Scott216/Leak_Detector/Eagle Files/Leak Detector Remote v3.brd

## EAGLE design Eagle Files/Leak Detector Remote v3.brd (2022-10-18)

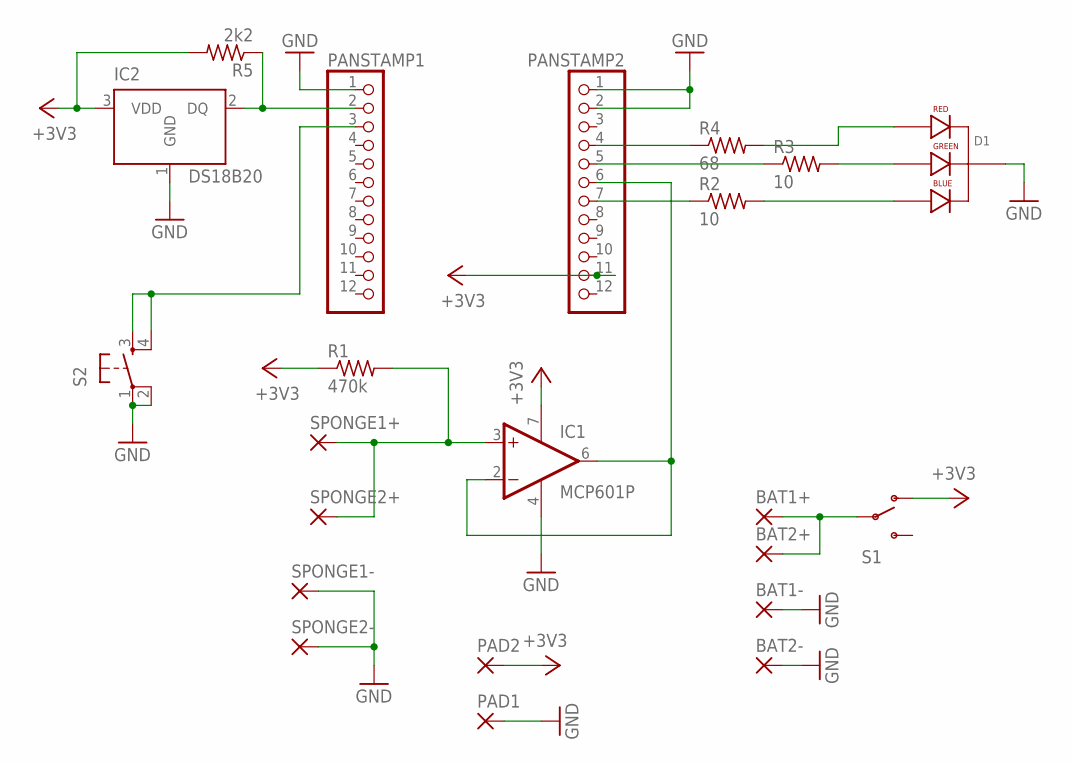
[picture p1: schematic Leak Detector Remote v3.sch]

Parts:
BAT1+, BAT1-, BAT2+, BAT2-: 3,81/1,4
D1: LED-RGB-CC-THRUCLEAR; LED-RGB-THRU
IC1: MCP601P; DIL08
IC2: DS18B20; TO-92
PAD1, PAD2: 1,6/0,9
PANSTAMP1, PANSTAMP2: PINHD-1X12; 1X12
R1: 470k; 0204/7
R2, R3: 10; 0204/7
R4: 68; 0204/7
R5: 2k2; 0204/7
S1: SWITCH-SPDTKIT; SWITCH-SPDT_KIT
S2: TAC_SWITCHPTH; TACTILE-PTH
SPONGE1+, SPONGE1-, SPONGE2+, SPONGE2-: 3,81/1,4

Connections:
+3V3: IC1.7 (V+), IC2.3 (VDD), PAD2.1, PANSTAMP2.11, R1.1, R5.2, S1.1 (O)
D3: PANSTAMP2.7, R2.1
D4: IC1.2 (-IN), IC1.6 (OUT), PANSTAMP2.6
D5: PANSTAMP2.5, R3.1
D6: PANSTAMP2.4, R4.1
D8: IC2.2 (DQ), PANSTAMP1.2, R5.1
D9: PANSTAMP1.3, S2.3, S2.4
GND: BAT1-.1, BAT2-.1, D1.2 (CATHODE), IC1.4 (V-), IC2.1 (GND), PAD1.1, PANSTAMP1.1, PANSTAMP2.1, PANSTAMP2.2, S2.1, S2.2, SPONGE1-.1, SPONGE2-.1
unnamed: IC1.3 (+IN), R1.2, SPONGE1+.1, SPONGE2+.1
unnamed: BAT1+.1, BAT2+.1, S1.2
unnamed: D1.1 (RED_CATHODE), R4.2
unnamed: D1.3 (GREEN_CATHODE), R3.2
unnamed: D1.4 (BLUE_CATHODE), R2.2

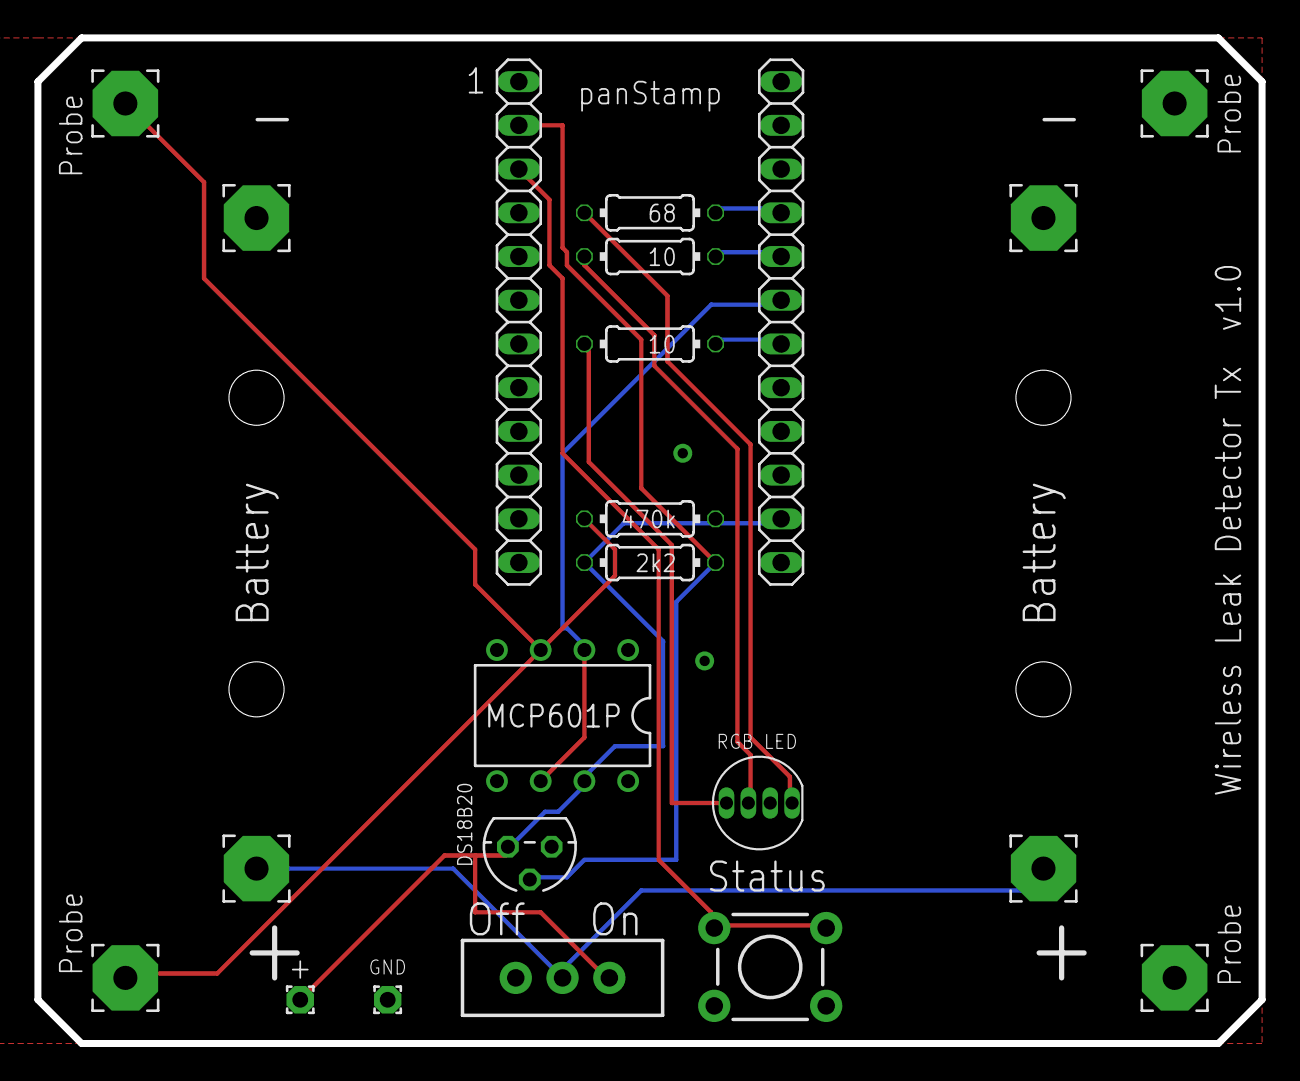
[picture p2: board Leak Detector Remote v3.brd from above]

Board: 2 copper layers, 71.1 x 58.4 mm, 22 parts (0 on the bottom side), 13 nets.
