Scott216/Leak_Detector/Eagle Files/Leak Detector v3.brd

## EAGLE design Eagle Files/Leak Detector v3.brd (2022-10-18)

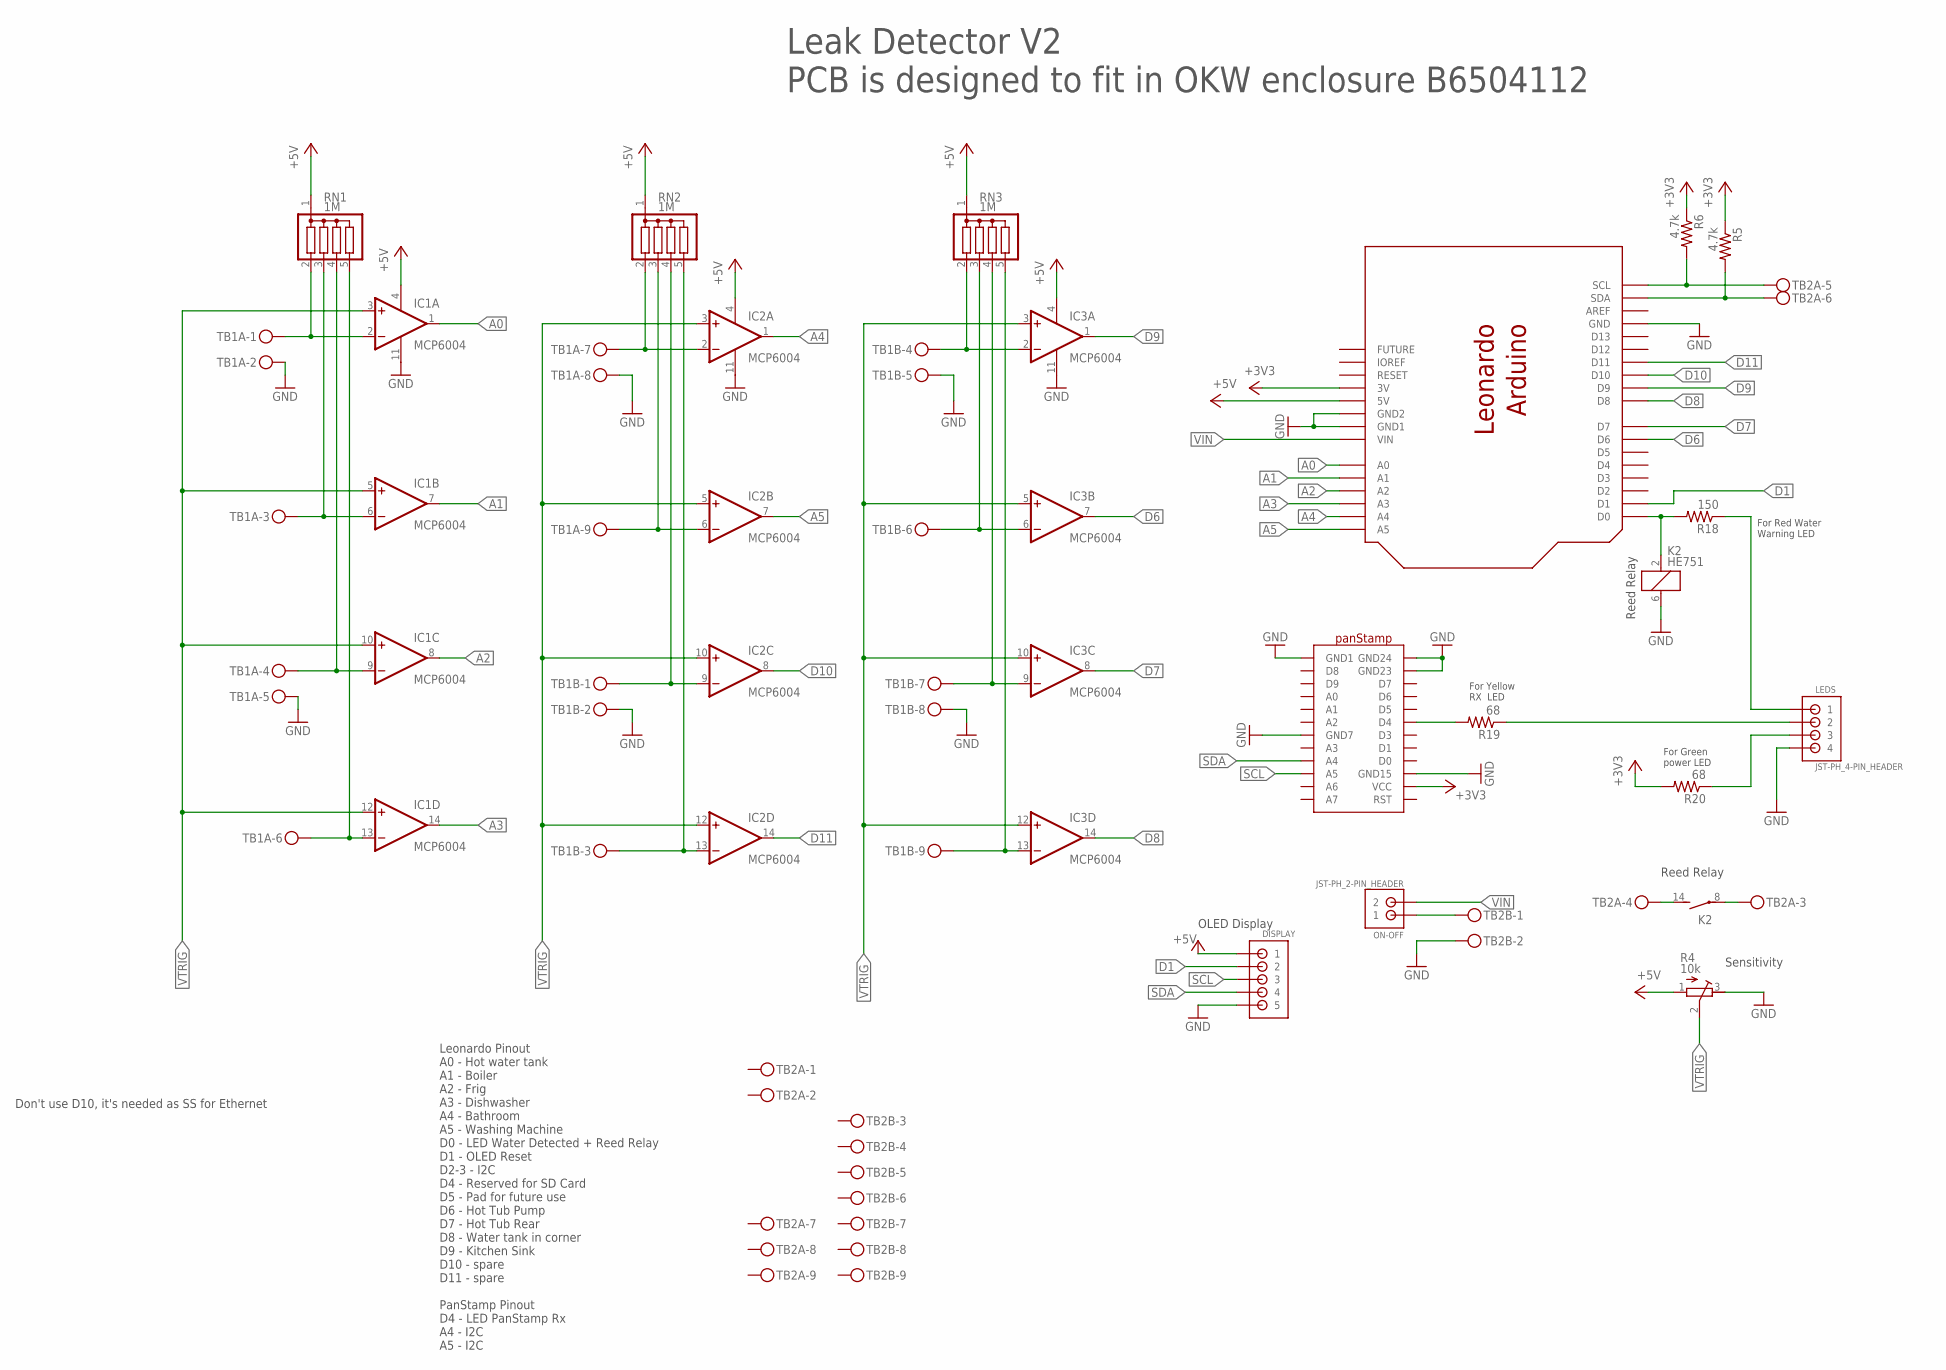
[picture p3: schematic Leak Detector v3.sch]

Parts:
DISPLAY: JST-PH_5-PIN_HEADER; JST_B5B-PH_HEADER
IC1, IC2, IC3: MCP6004; DIL14
K2: HE751
LEDS: JST-PH_4-PIN_HEADER; JST_B4B-PH_HEADER
ON-OFF: JST-PH_2-PIN_HEADER; JST_B2B-PH_HEADER
R4: 10k; RTRIM3296P
R5, R6: 4.7k; 0207/10
R18: 150; 0207/10
R19, R20: 68; 0207/10
RN1, RN2, RN3: 1M; SIL5
TB1A, TB1B, TB2A, TB2B: MKDSN1,5/9-5,08
U$1: ARDUINO_LEONARDO
U$2: PANSTAMP

Connections:
+3V3: R5.1, R6.1, R20.2, U$1.3V, U$2.VCC
+5V: DISPLAY.P1 (1), IC1.4 (V+), IC2.4 (V+), IC3.4 (V+), R4.1 (E), RN1.1, RN2.1, RN3.1, U$1.5V
A0: IC1.1 (OUT), U$1.A0
A1: IC1.7 (OUT), U$1.A1
A2: IC1.8 (OUT), U$1.A2
A3: IC1.14 (OUT), U$1.A3
A4: IC2.1 (OUT), U$1.A4
A5: IC2.7 (OUT), U$1.A5
BATHROOM: IC2.2 (-IN), RN2.2, TB1A.7
BOILER: IC1.6 (-IN), RN1.3, TB1A.3
D1: DISPLAY.P2 (2), U$1.D1
D6: IC3.7 (OUT), U$1.D6
D7: IC3.8 (OUT), U$1.D7
D8: IC3.14 (OUT), U$1.D8
D9: IC3.1 (OUT), U$1.D9
D10: IC2.8 (OUT), U$1.D10
D11: IC2.14 (OUT), U$1.D11
DISHWASHER: IC1.13 (-IN), RN1.5, TB1A.6
FRIG: IC1.9 (-IN), RN1.4, TB1A.4
GND: DISPLAY.P5 (5), IC1.11 (V-), IC2.11 (V-), IC3.11 (V-), K2.6 (2), LEDS.P4 (4), R4.3 (A), TB1A.2, TB1A.5, TB1A.8, TB1B.2, TB1B.5, TB1B.8, TB2B.2, U$1.GND, U$1.GND$2 (GND2), U$1.GND$3 (GND1), U$2.GND1, U$2.GND7, U$2.GND15, U$2.GND23, U$2.GND24
HAVEPOWER: LEDS.P3 (3), R20.1
HOT_TUB_PUMP: IC3.6 (-IN), RN3.3, TB1B.6
HOT_TUB_REAR: IC3.9 (-IN), RN3.4, TB1B.7
HOT_WATER_TANK: IC1.2 (-IN), RN1.2, TB1A.1
ISWATER: LEDS.P1 (1), R18.1
unnamed: ON-OFF.P1 (1), TB2B.1
unnamed: K2.2 (1), R18.2, U$1.D0
unnamed: K2.14 (S), TB2A.4
unnamed: K2.8, TB2A.3
unnamed: R19.2, U$2.D4
RXOK: LEDS.P2 (2), R19.1
SCL: DISPLAY.P3 (3), R6.2, TB2A.5, U$1.SCL, U$2.A5
SDA: DISPLAY.P4 (4), R5.2, TB2A.6, U$1.SDA, U$2.A4
SINK: IC3.2 (-IN), RN3.2, TB1B.4
SPARE1: IC2.9 (-IN), RN2.4, TB1B.1
SPARE2: IC2.13 (-IN), RN2.5, TB1B.3
VIN: ON-OFF.P2 (2), U$1.VIN
VTRIG: IC1.3 (+IN), IC1.5 (+IN), IC1.10 (+IN), IC1.12 (+IN), IC2.3 (+IN), IC2.5 (+IN), IC2.10 (+IN), IC2.12 (+IN), IC3.3 (+IN), IC3.5 (+IN), IC3.10 (+IN), IC3.12 (+IN), R4.2 (S)
WASH_MACH: IC2.6 (-IN), RN2.3, TB1A.9
WATER_TANK: IC3.13 (-IN), RN3.5, TB1B.9

Notes on the sheet:
Leonardo Pinout A0 - Hot water tank A1 - Boiler A2 - Frig A3 - Dishwasher A4 - Bathroom A5 - Washing Machine D0 - LED Water Detected + Reed Relay D1 - OLED Reset D2-3 - I2C D4 - Reserved for SD Card D5 - Pad for future use D6 - Hot Tub Pump D7 - Hot Tub Rear D8 - Water tank in corner D9 - Kitchen S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
Leak Detector V2 PCB is designed to fit in OKW enclosure B6504112
OLED Display
Reed Relay
Sensitivity
For Green power LED
For Yellow RX LED
For Red Water Warning LED
Don't use D10, it's needed as SS for Ethernet

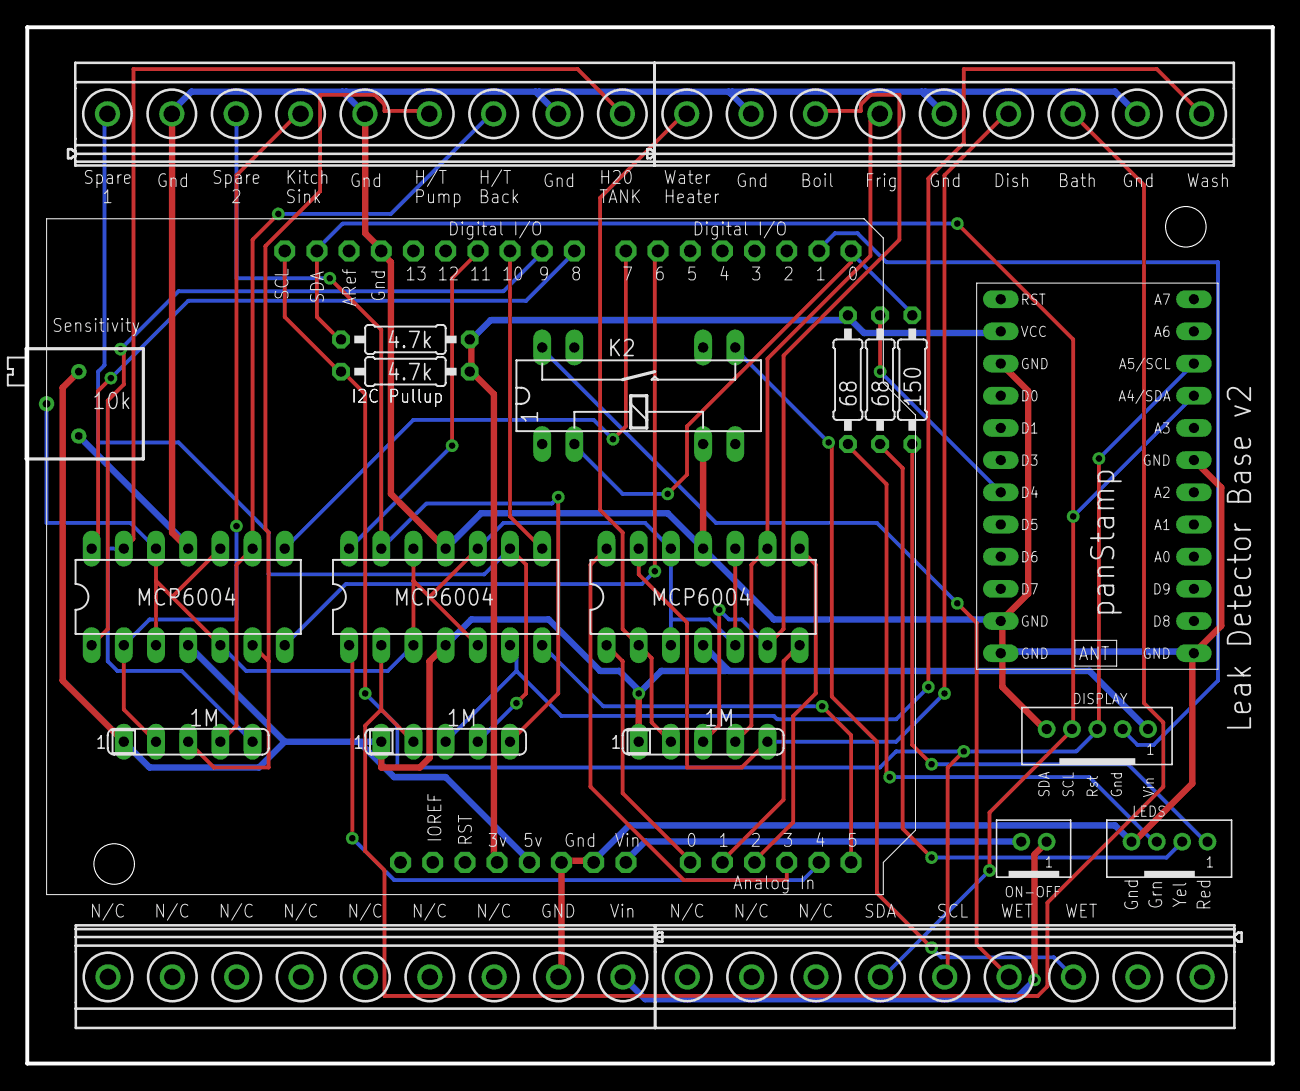
[picture p4: board Leak Detector v3.brd from above]

Board: 2 copper layers, 98.3 x 81.8 mm, 22 parts (0 on the bottom side), 40 nets.
