Scott216/Leak_Detector/(commit log)

2021-01-08 v1.03 - added buzzer output
    [Leak_Detector.py]
2021-02-18 ver 1.04 minor fixes
    [Leak_Detector.py]
2021-02-19 ver 1.05 printout changes
2022-10-18 Arduino (Panstamp) Wireless Receiver
2022-10-18 Arduino (Panstamp) Wireless Transmitter
2022-10-18 Schematic and board file for wireless transmitter
    [Leak Detector Remote v3.brd, Leak Detector Remote v3.sch, Leak Detector v3.brd, Leak Detector v3.sch]
2023-03-14 v1.11 Bug - missing statusMsg
    Fixed bug introduced in v1.10
    [Leak_Detector.py]
